AwJindo/Stabilizing-unit/README.md

# Stabilizing-unit
Projectcourse made in KTH by Amir K, Sami K, Maiar S, Rajinder S

A stabilizator unit for cutleries to help people with tremors.
