AwJindo/Stabilizing-unit/Stabilizing unit presentation.pptx

## Stabilisering Enhet

Amir K, Maiar S, Raj S, Sami K

## Slide 2

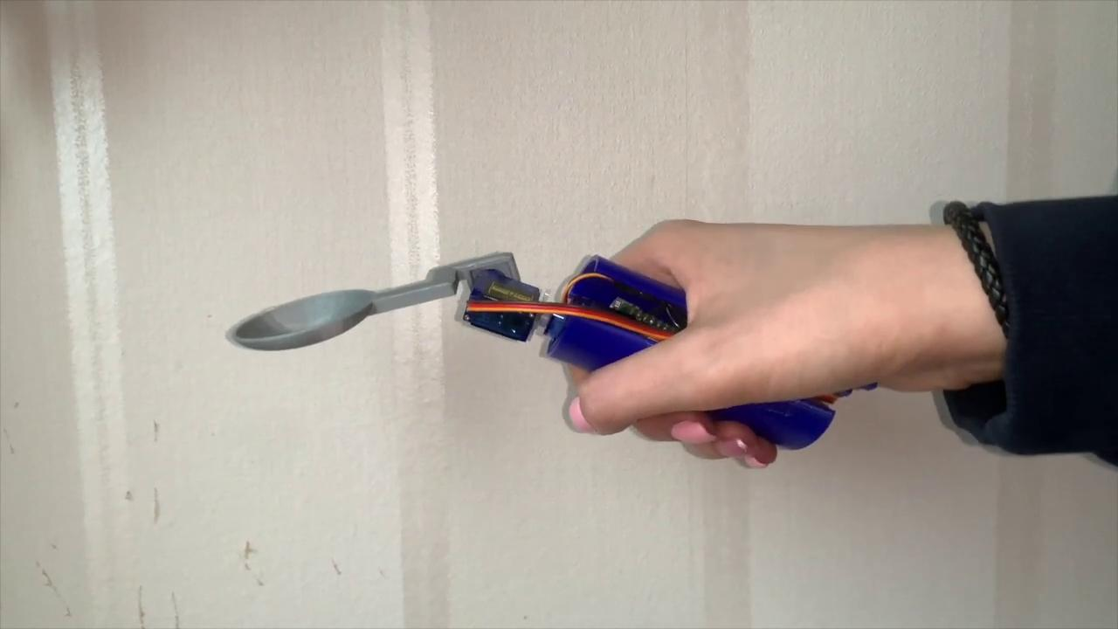
[picture p1: figure]

## Why this is a problem and alternative solutions

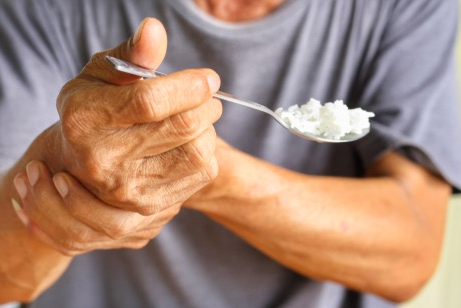
[picture p2: figure]
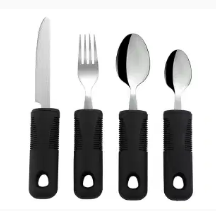
[picture p3: figure]

## Our solution

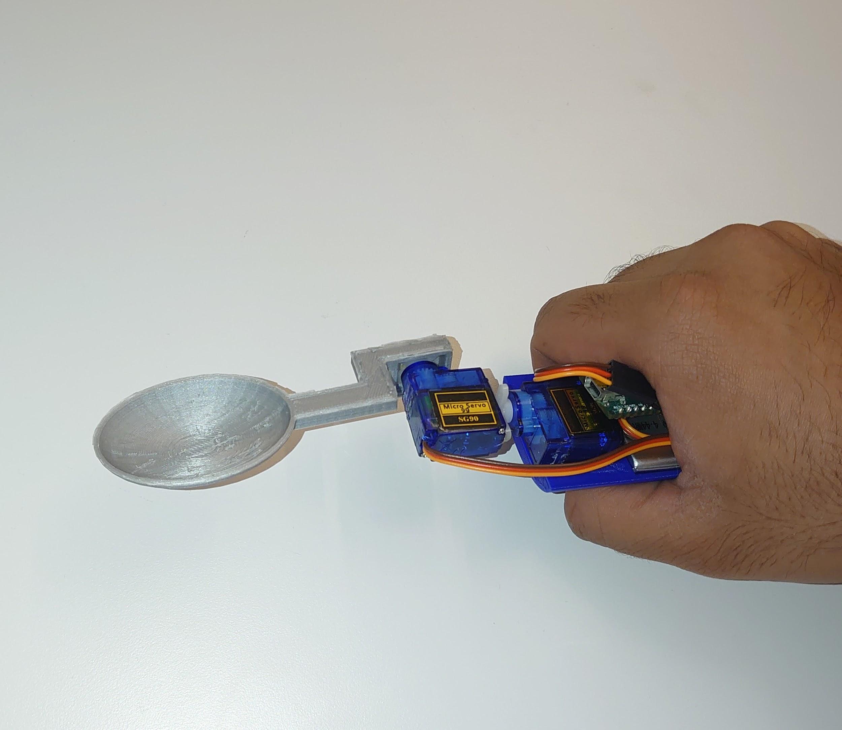
[picture p4: figure]
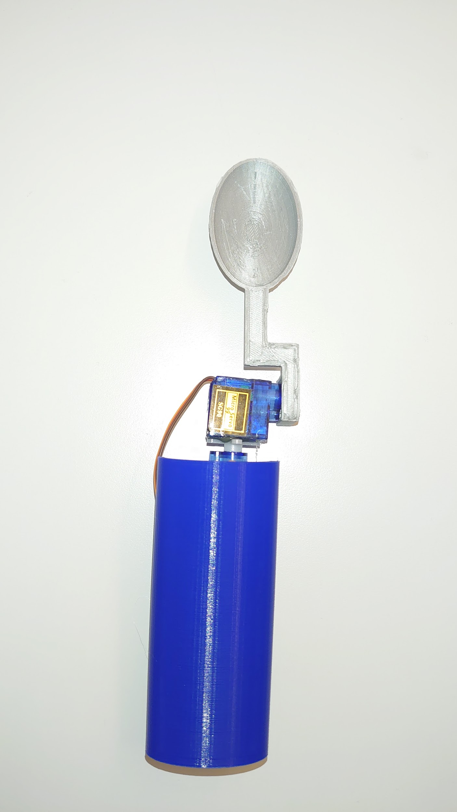
[picture p5: figure]

## Technical part

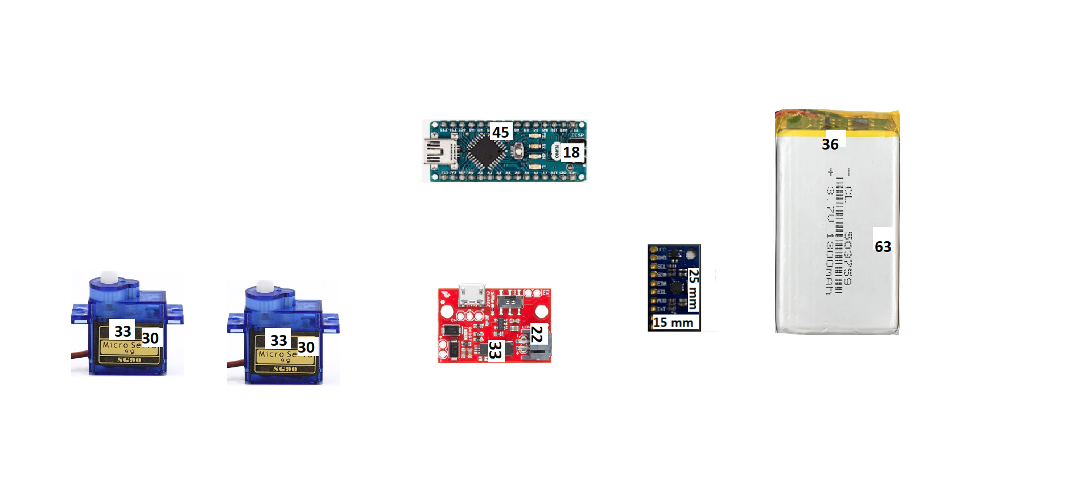
[picture p6: figure]

- Simplicity of the design
- Battery

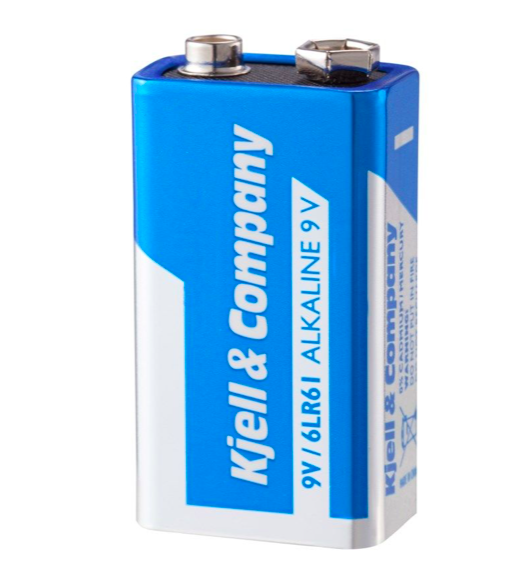
[picture p7: figure]
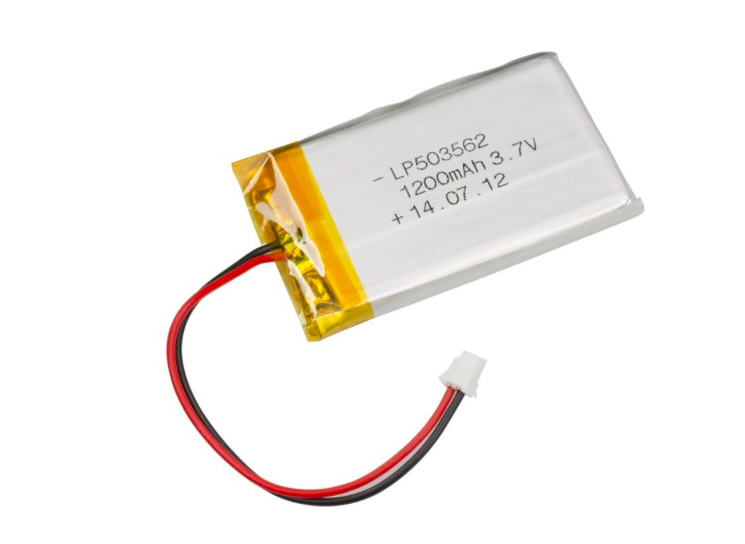
[picture p8: figure]
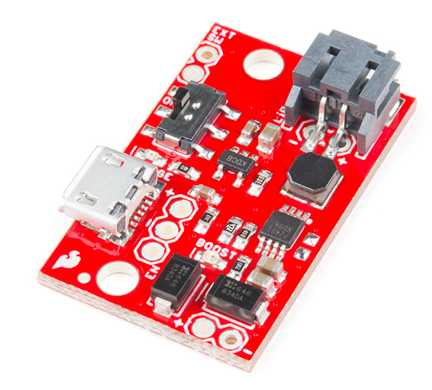
[picture p9: figure]

## Result

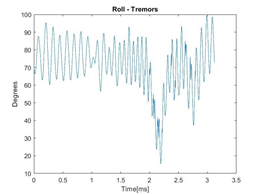
[picture p10: figure]
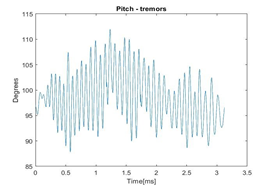
[picture p11: figure]

## Future work

- We could have used an Arduino chip with built in accelerometer instead of using a different component for that.
- Battery
- Design
- Servo motors
