AwJindo/Stabilizing-unit/spoon.stl

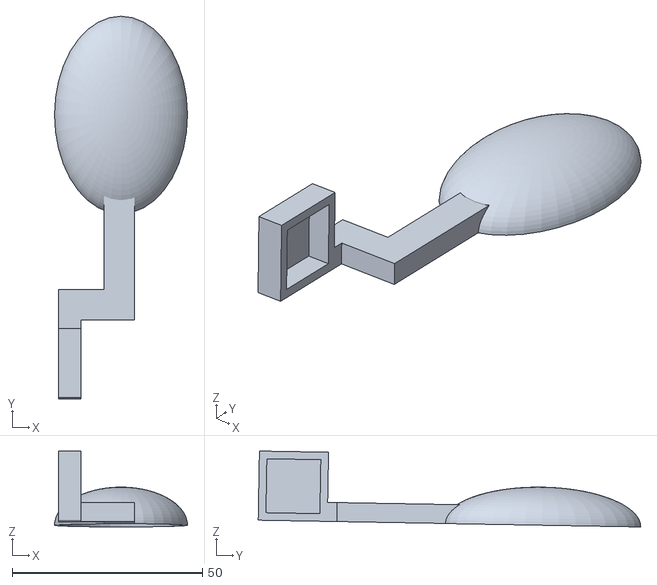
[picture p20: CAD file, 2021-01-11]
spoon.stl
35.0 x 100.7 x 20.0
