AwJindo/Stabilizing-unit/lower_case.stl

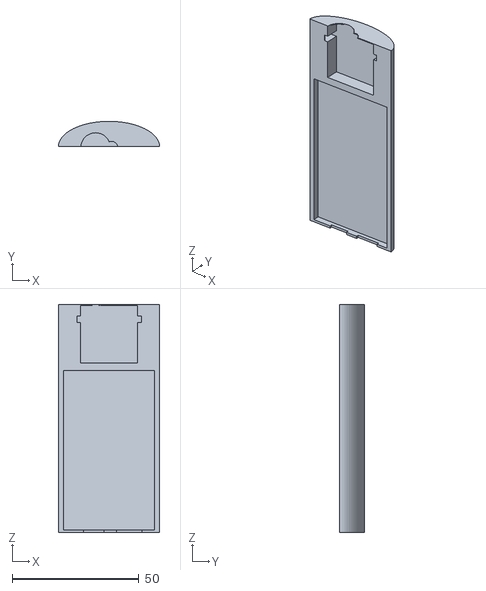
[picture p21: CAD file, 2021-01-11]
lower_case.stl
40.0 x 10.0 x 90.0
