AwJindo/Stabilizing-unit/upper_case.stl

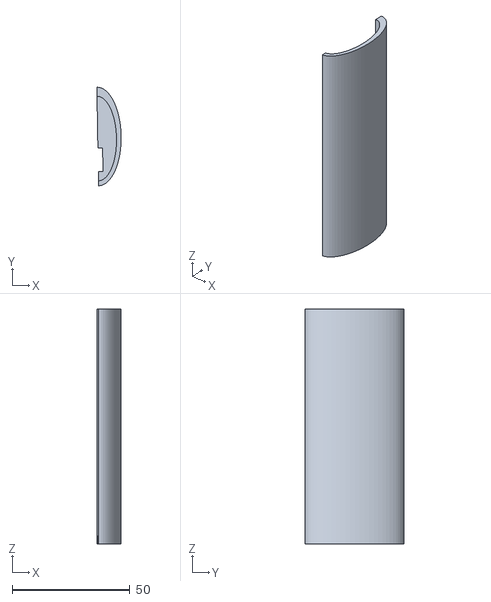
[picture p22: CAD file, 2021-01-11]
upper_case.stl
10.4 x 42.0 x 100.0
